halitosisman/SeniorDesign/Pcb/Main/Main.png

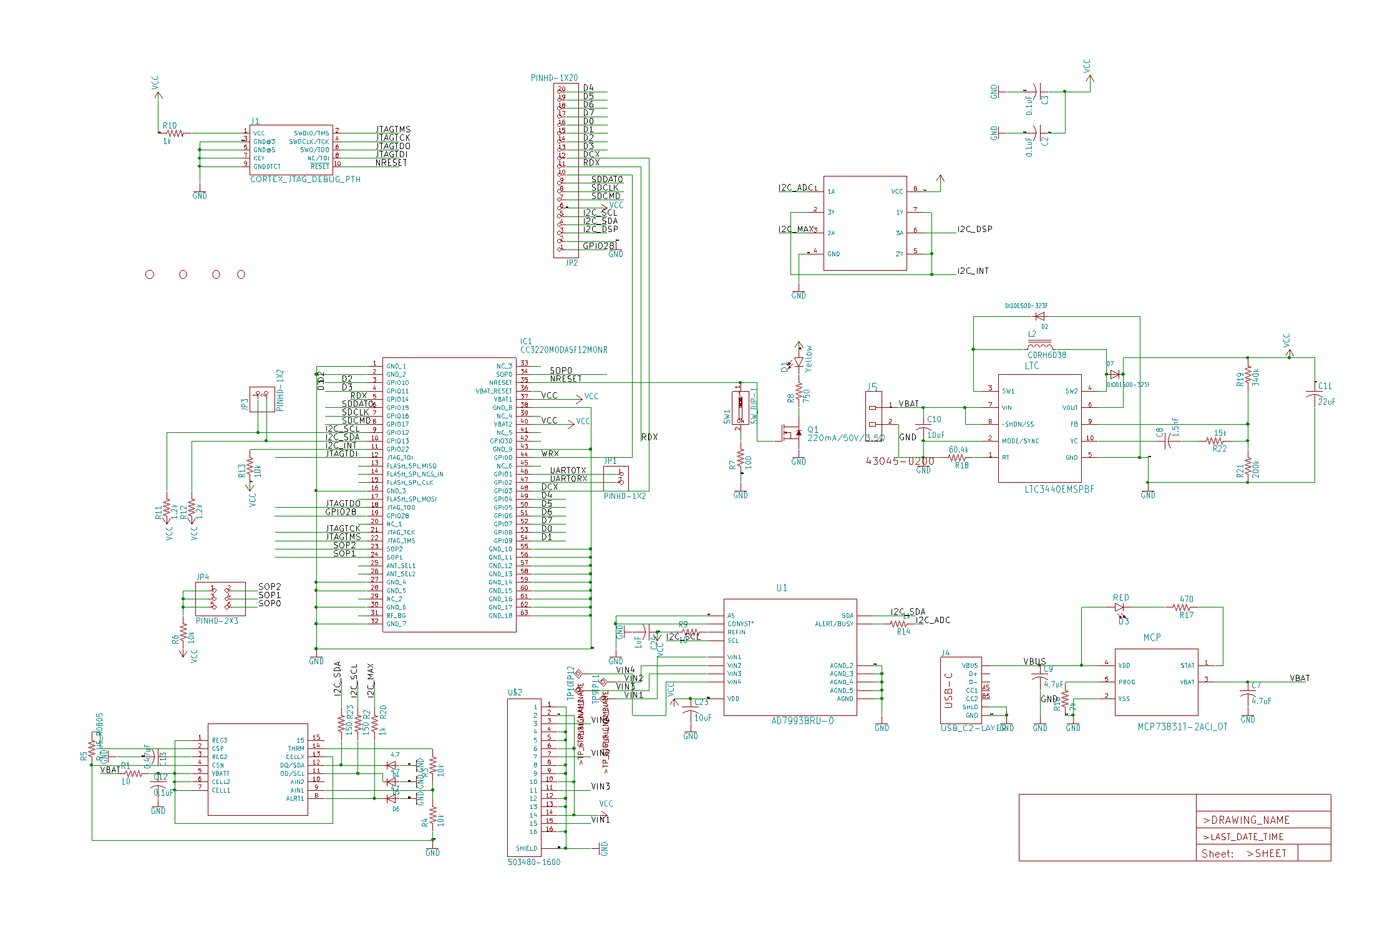
Pcb/Main/Main.png
