halitosisman/SeniorDesign/(list of files, cad)

Other CAD files:
Mechanical/3d/MockupV1.blend
