halitosisman/SeniorDesign/Pcb/Display/Display.brd

## EAGLE design Pcb/Display/Display.brd (2020-04-03)

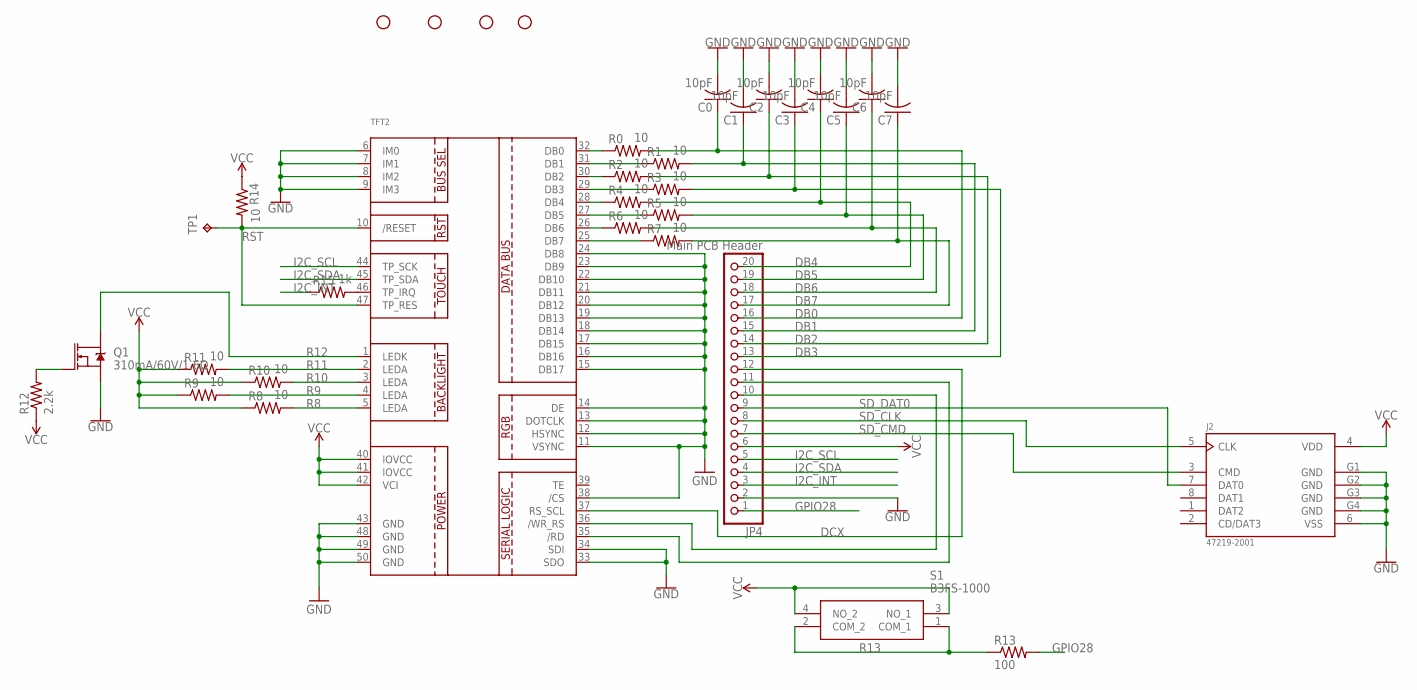
[picture p6: schematic Display.sch]

Parts:
C0, C1, C2, C3, C4, C5, C6, C7: 10pF; C0805
H1, H2, H3, H4: STAND-OFF
J2: 47219-2001; MOLEX_47219-2001
JP4: Main PCB Header; 1X20
Q1: 310mA/60V/1.6Ω; SOT323
R0, R1, R2, R3, R4, R5, R6, R7, R8, R9, R10, R11, R14: 10; R0805
R12: 2.2k; M0805
R13: 100; R0805
R15: 1k; R0805
S1: B3FS-1000; B3FS1000
TFT2: DISP_LCD_CTP28_DATASHEET; TFT_CTP28
TP1: TPTP09R; TP09R

Connections:
DB0: C0.1, JP4.16, R0.2
DB1: C1.1, JP4.15, R1.2
DB2: C2.1, JP4.14, R2.2
DB3: C3.1, JP4.13, R3.2
DB4: C4.1, JP4.20, R4.2
DB5: C5.1, JP4.19, R5.2
DB6: C6.1, JP4.18, R6.2
DB7: C7.1, JP4.17, R7.2
DCX: JP4.12, TFT2.37 (RS_SCL)
GND: C0.2, C1.2, C2.2, C3.2, C4.2, C5.2, C6.2, C7.2, J2.6 (VSS), J2.G1 (GND), J2.G2 (GND), J2.G3 (GND), J2.G4 (GND), JP4.2, Q1.2 (S), TFT2.6 (IM0), TFT2.7 (IM1), TFT2.8 (IM2), TFT2.9 (IM3), TFT2.11 (VSYNC), TFT2.12 (HSYNC), TFT2.13 (DOTCLK), TFT2.14 (DE), TFT2.15 (DB17), TFT2.16 (DB16), TFT2.17 (DB15), TFT2.18 (DB14), TFT2.19 (DB13), TFT2.20 (DB12), TFT2.21 (DB11), TFT2.22 (DB10), TFT2.23 (DB9), TFT2.24 (DB8), TFT2.33 (SDO), TFT2.34 (SDI), TFT2.38 (/CS), TFT2.43 (GND), TFT2.48 (GND), TFT2.49 (GND), TFT2.50 (GND)
GPIO28: JP4.1, R13.2
I2C_INT: JP4.3, R15.1
I2C_SCL: JP4.5, TFT2.44 (TP_SCK)
I2C_SDA: JP4.4, TFT2.45 (TP_SDA)
unnamed: R0.1, TFT2.32 (DB0)
unnamed: R1.1, TFT2.31 (DB1)
unnamed: R2.1, TFT2.30 (DB2)
unnamed: R15.2, TFT2.46 (TP_IRQ)
unnamed: R3.1, TFT2.29 (DB3)
unnamed: R4.1, TFT2.28 (DB4)
unnamed: R5.1, TFT2.27 (DB5)
unnamed: R7.1, TFT2.25 (DB7)
unnamed: R6.1, TFT2.26 (DB6)
unnamed: Q1.1 (G), R12.2
R8: R8.2, TFT2.5 (LEDA)
R9: R9.2, TFT2.4 (LEDA)
R10: R10.2, TFT2.3 (LEDA)
R11: R11.2, TFT2.2 (LEDA)
R12: Q1.3 (D), TFT2.1 (LEDK)
R13: R13.1, S1.1 (COM_1), S1.2 (COM_2)
RDX: JP4.11, TFT2.35 (/RD)
RST: R14.2, TFT2.10 (/RESET), TFT2.47 (TP_RES), TP1.TP
SD_CLK: J2.5 (CLK), JP4.8
SD_CMD: J2.3 (CMD), JP4.7
SD_DAT0: J2.7 (DAT0), JP4.9
VCC: J2.4 (VDD), JP4.6, R8.1, R9.1, R10.1, R11.1, R12.1, R14.1, S1.3 (NO_1), S1.4 (NO_2), TFT2.40 (IOVCC), TFT2.41 (IOVCC), TFT2.42 (VCI)
WRX: JP4.10, TFT2.36 (/WR_RS)

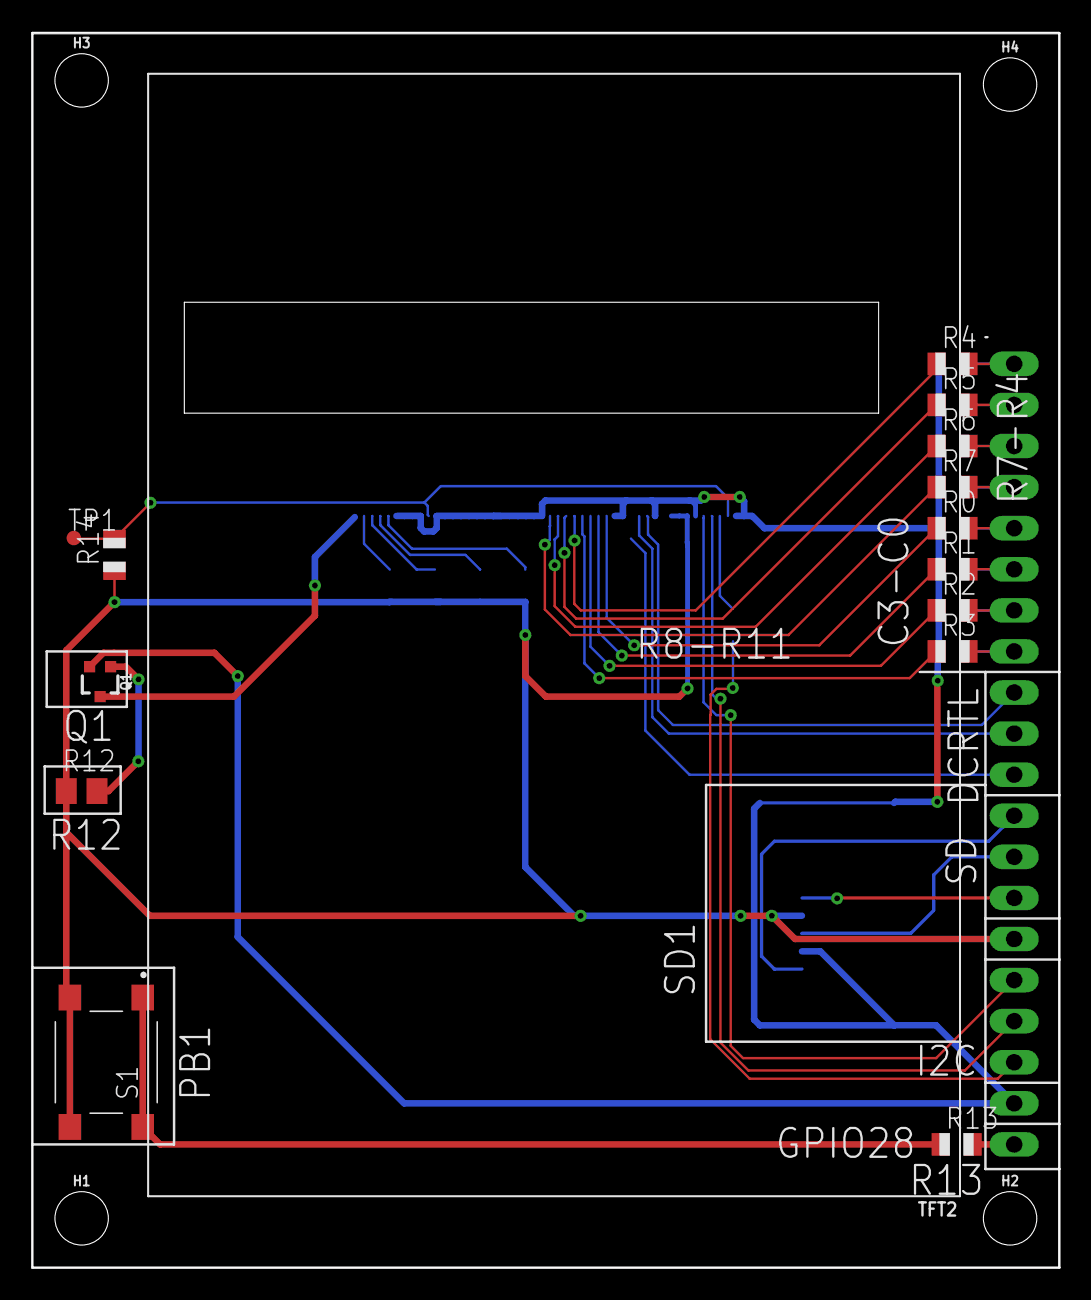
[picture p7: board Display.brd from above]

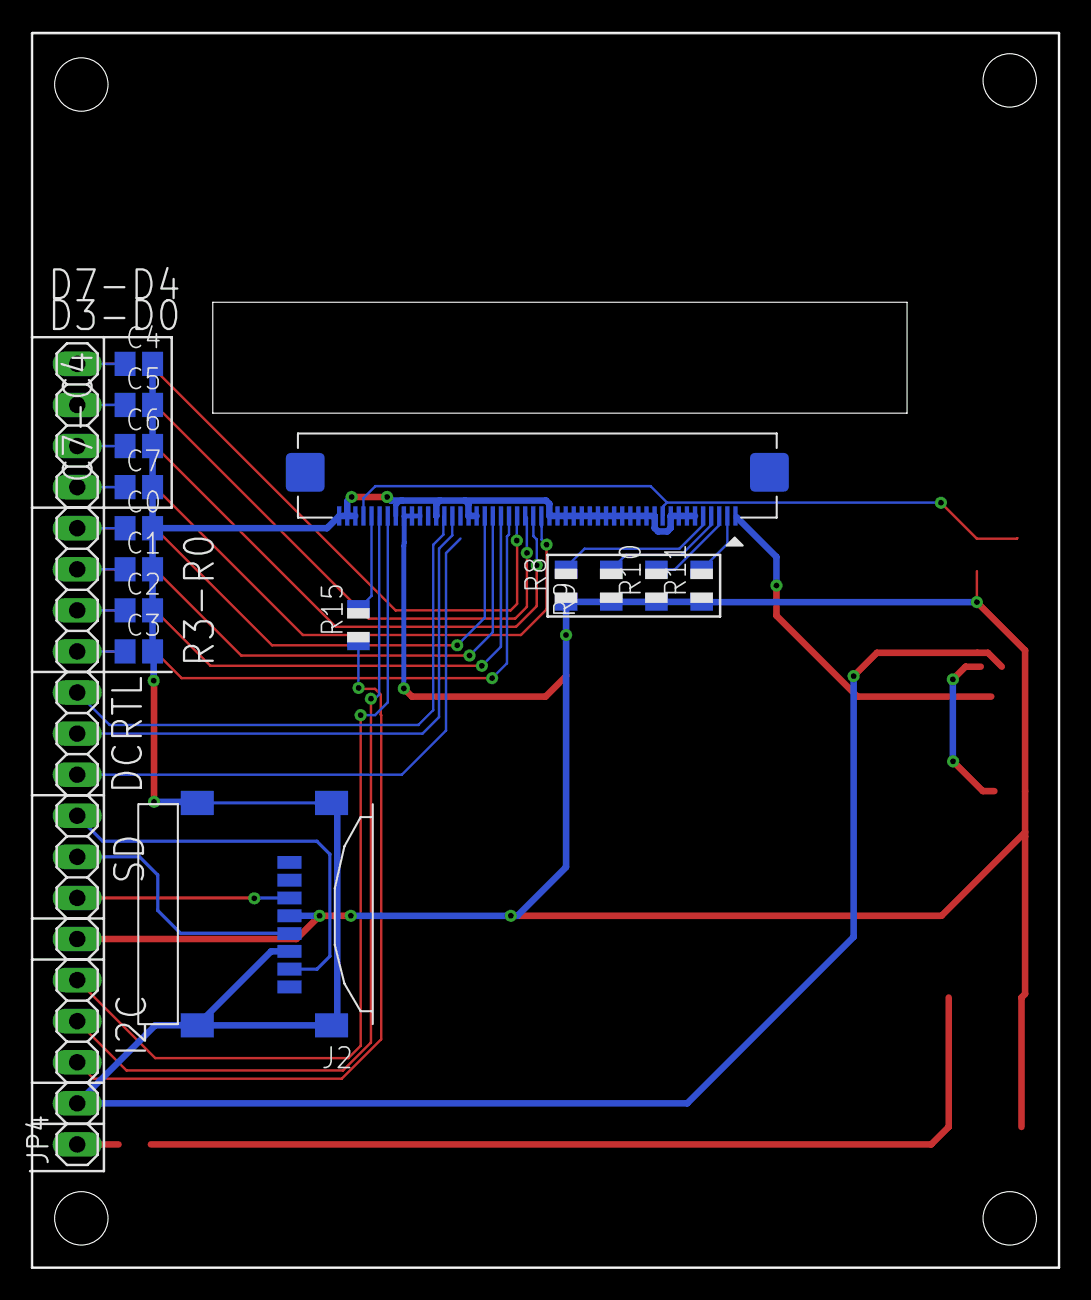
[picture p8: board Display.brd from below]

Board: 2 copper layers, 63.5 x 76.4 mm, 34 parts (15 on the bottom side), 37 nets.
