halitosisman/SeniorDesign/Pcb/Main/Main_v3.brd

## EAGLE design Pcb/Main/Main_v3.brd (2020-04-03)

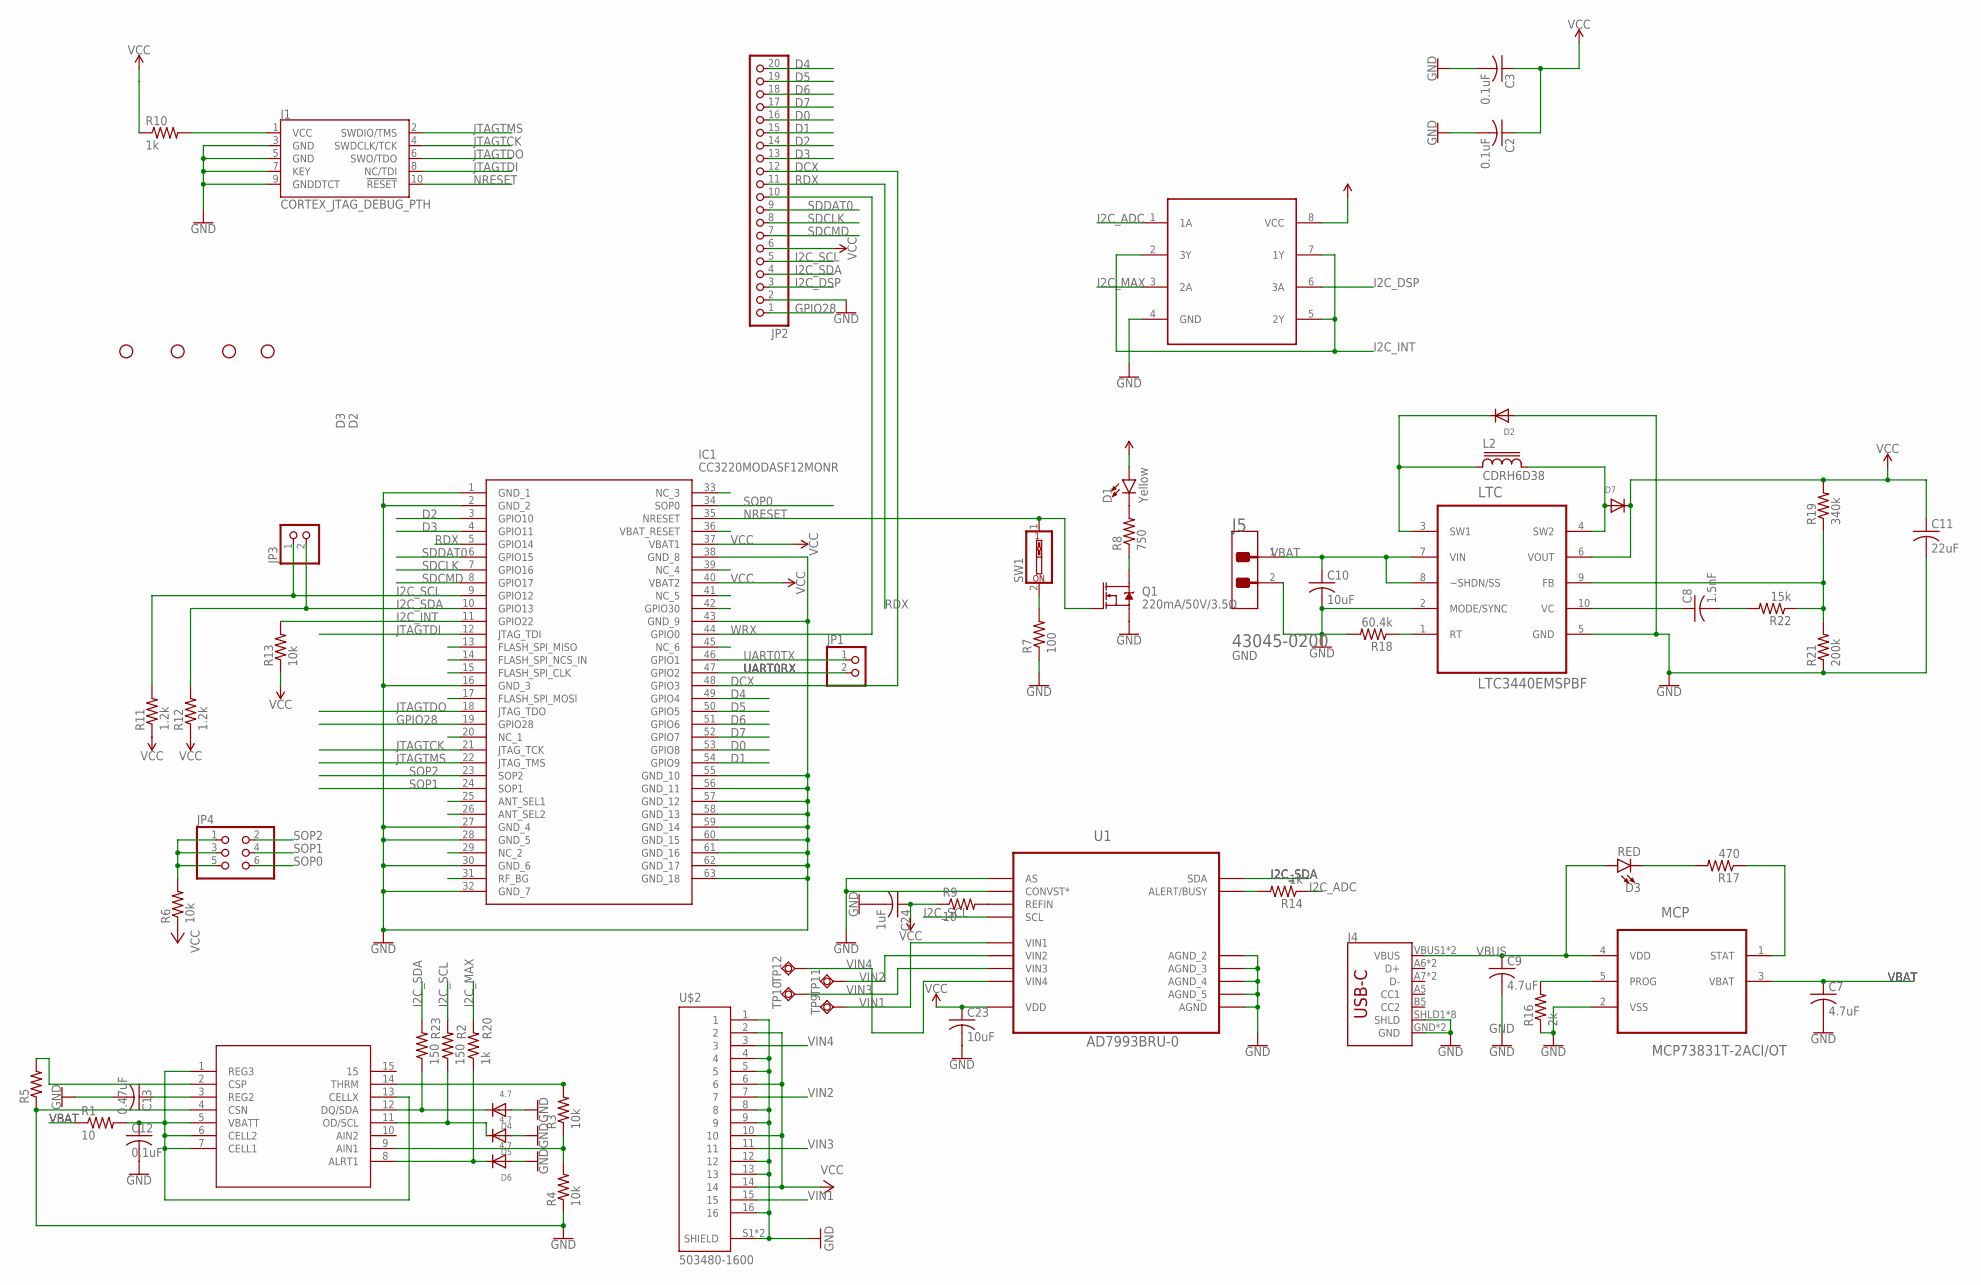
[picture p9: schematic Main_v3.sch]

Parts:
74LVC: SOP65P400X110-8N
C2, C3, C12: 0.1uF; C0805
C7, C9: 4.7uF; C0805
C8: 1.5nF; C0805
C10, C23: 10uF; C0805
C11: 22uF; C1210
C13: 0.47uF; C0805
C24: 1uF; C0805
D1: Yellow; LED-0603
D2, D7: DIODESOD-323F; SOD-323F
D3: RED; LED-0603
D4, D5, D6: 4.7; SOD-323F
H1, H2, H3, H4: STAND-OFF
IC1: CC3220MODASF12MONR; CC3220MODASM2MONR
J1: CORTEX_JTAG_DEBUG_PTH; 2X5-PTH-1.27MM
J4: USB_C2-LAYER; USB-C-16P
J5: MOLEX_43045-0200MOLEX_43045-0200_0_0; MOLEX_43045-0200_0
JP1, JP3: PINHD-1X2; 1X02
JP2: PINHD-1X20; 1X20
JP4: PINHD-2X3; 2X03
L2: CDRH6D38; CDRH6D
LTC: LTC3440EMSPBF; SOP50P490X110-10N
MAX: MAX17201G+T; 21-0137I_T1433-1
MCP: MCP73831T-2ACI/OT; SOT95P280X145-5N
Q1: 220mA/50V/3.5Ω; SOT23-3
R1, R9: 10; R0805
R2, R23: 150; R0805
R3, R4, R6, R13: 10k; R0805
R5: R-US_R0805; R0805
R7: 100; R0805
R8: 750; R0805
R10, R14, R20: 1k; R0805
R11, R12: 1.2k; R0805
R16: 2k; R0805
R17: 470; R0805
R18: 60.4k; R0805
R19: 340k; R0805
R21: 200k; R0805
R22: 15k; R0805
SW1: SW_DIP-1; EDG-01
TP9, TP10, TP11, TP12: TPSQTP12R; TP12R
U1: AD7993BRU-0; SOP65P640X120-16N
U$2: 503480-1600; MOLEX_503480-1600

Connections:
D0: IC1.53 (GPIO8), JP2.16
D1: IC1.54 (GPIO9), JP2.15
D2: IC1.3 (GPIO10), JP2.14
D3: IC1.4 (GPIO11), JP2.13
D4: IC1.49 (GPIO4), JP2.20
D5: IC1.50 (GPIO5), JP2.19
D6: IC1.51 (GPIO6), JP2.18
D7: IC1.52 (GPIO7), JP2.17
DCX: IC1.48 (GPIO3), JP2.12
GND: 74LVC.4 (GND), C2.2, C3.2, C7.2, C9.2, C10.2, C11.2, C12.2, C13.2, C23.2, C24.2, D2.A, D4.A, D5.A, D6.A, IC1.1 (GND_1), IC1.2 (GND_2), IC1.16 (GND_3), IC1.27 (GND_4), IC1.28 (GND_5), IC1.30 (GND_6), IC1.32 (GND_7), IC1.38 (GND_8), IC1.43 (GND_9), IC1.55 (GND_10), IC1.56 (GND_11), IC1.57 (GND_12), IC1.58 (GND_13), IC1.59 (GND_14), IC1.60 (GND_15), IC1.61 (GND_16), IC1.62 (GND_17), IC1.63 (GND_18), J1.3 (GND), J1.5 (GND), J1.7 (KEY), J1.9 (GNDDTCT), J4.GND, J4.GND2 (GND), J4.SHLD1 (SHLD), J4.SHLD2 (SHLD), J4.SHLD3 (SHLD), J4.SHLD4 (SHLD), J4.SHLD5 (SHLD), J4.SHLD6 (SHLD), J4.SHLD7 (SHLD), J4.SHLD8 (SHLD), J5.2, JP2.2, LTC.2 (MODE/SYNC), LTC.5 (GND), MAX.4 (CSN), MCP.2 (VSS), Q1.2 (S), R4.1, R5.1, R7.1, R16.1, R18.2, R21.1, U1.1 (AGND_2), U1.2 (AGND_3), U1.3 (AGND_4), U1.4 (AGND_5), U1.11 (AS), U1.12 (CONVST*), U1.16 (AGND), U$2.1, U$2.4, U$2.5, U$2.8, U$2.9, U$2.12, U$2.13, U$2.16, U$2.S1 (SHIELD), U$2.S2 (SHIELD)
GPIO28: IC1.19 (GPIO28), JP2.1
I2C_ADC: 74LVC.1 (1A), R14.1
I2C_DSP: 74LVC.6 (3A), JP2.3
I2C_INT: 74LVC.2 (3Y), 74LVC.5 (2Y), 74LVC.7 (1Y), IC1.11 (GPIO22), R13.2
I2C_MAX: 74LVC.3 (2A), R20.2
I2C_SCL: IC1.9 (GPIO12), JP2.5, JP3.1, R2.2, R11.2, U1.15 (SCL)
I2C_SDA: IC1.10 (GPIO13), JP2.4, JP3.2, R12.2, R23.2, U1.14 (SDA)
JTAGTCK: IC1.21 (JTAG_TCK), J1.4 (SWDCLK/TCK)
JTAGTDI: IC1.12 (JTAG_TDI), J1.8 (NC/TDI)
JTAGTDO: IC1.18 (JTAG_TDO), J1.6 (SWO/TDO)
JTAGTMS: IC1.22 (JTAG_TMS), J1.2 (SWDIO/TMS)
JTAG_R: J1.1 (VCC), R10.2
LTC_CRS: C8.2, R22.2
LTC_FB: LTC.9 (FB), R19.1, R21.2, R22.1
LTC_IND1: D2.C, L2.1, LTC.3 (SW1)
LTC_IND2: D7.A, L2.2, LTC.4 (SW2)
LTC_RT: LTC.1 (RT), R18.1
LTC_VC: C8.1, LTC.10 (VC)
MAX_AIN1: MAX.9 (AIN1), R3.1, R4.2
MAX_CSP: MAX.2 (CSP), R5.2
MAX_INT: D6.C, MAX.8 (ALRT1), R20.1
MAX_REG2: C13.1, MAX.3 (REG2)
MAX_SCL: D5.C, MAX.11 (OD/SCL), R2.1
MAX_SDA: D4.C, MAX.12 (DQ/SDA), R23.1
MAX_THRM: MAX.14 (THRM), R3.2
MAX_VBAT: C12.1, MAX.1 (REG3), MAX.5 (VBATT), MAX.6 (CELL2), MAX.7 (CELL1), MAX.13 (CELLX), R1.2
MPC_LED: D3.C, R17.2
MPC_RPROG: MCP.5 (PROG), R16.2
MPC_STAT: MCP.1 (STAT), R17.1
unnamed: JP4.1, JP4.3, JP4.5, R6.2
unnamed: R9.2, U1.6 (REFIN)
unnamed: R14.2, U1.13 (ALERT/BUSY)
NRESET: IC1.35 (NRESET), J1.10 (!RESET), Q1.1 (G), SW1.1
RDX: IC1.5 (GPIO14), JP2.11
RESET_DIODE: D1.C, R8.2
RESET_MOS: Q1.3 (D), R8.1
RESET_SW1: R7.2, SW1.2
SDCLK: IC1.7 (GPIO16), JP2.8
SDCMD: IC1.8 (GPIO17), JP2.7
SDDAT0: IC1.6 (GPIO15), JP2.9
SOP0: IC1.34 (SOP0), JP4.6
SOP1: IC1.24 (SOP1), JP4.4
SOP2: IC1.23 (SOP2), JP4.2
UART0RX: IC1.47 (GPIO2), JP1.2
UART0TX: IC1.46 (GPIO1), JP1.1
VBAT: C7.1, C10.1, J5.1, LTC.7 (VIN), LTC.8 (~SHDN/SS), MCP.3 (VBAT), R1.1
VBUS: C9.1, D3.A, J4.VBUS1 (VBUS), J4.VBUS2 (VBUS), MCP.4 (VDD)
VCC: 74LVC.8 (VCC), C2.1, C3.1, C11.1, C23.1, C24.1, D1.A, D7.C, IC1.37 (VBAT1), IC1.40 (VBAT2), JP2.6, LTC.6 (VOUT), R6.1, R9.1, R10.1, R11.1, R12.1, R13.1, R19.2, U1.5 (VDD), U$2.2, U$2.6, U$2.10, U$2.14
VIN1: TP9.TP, U1.7 (VIN1), U$2.15
VIN2: TP11.TP, U1.10 (VIN2), U$2.7
VIN3: TP10.TP, U1.8 (VIN3), U$2.11
VIN4: TP12.TP, U1.9 (VIN4), U$2.3
WRX: IC1.44 (GPIO0), JP2.10

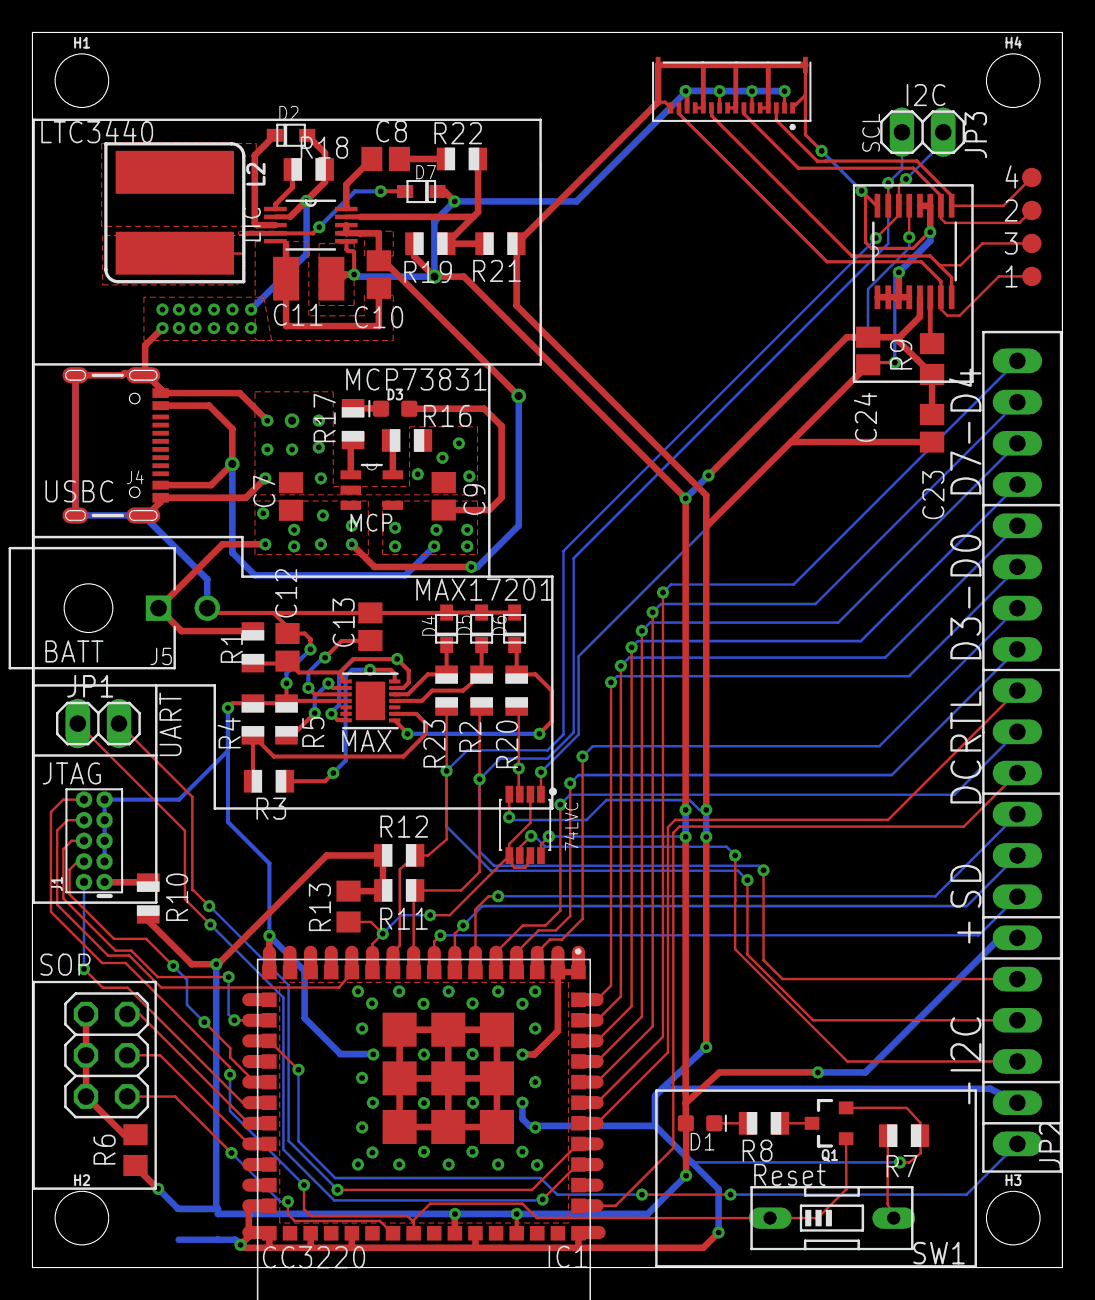
[picture p10: board Main_v3.brd from above]

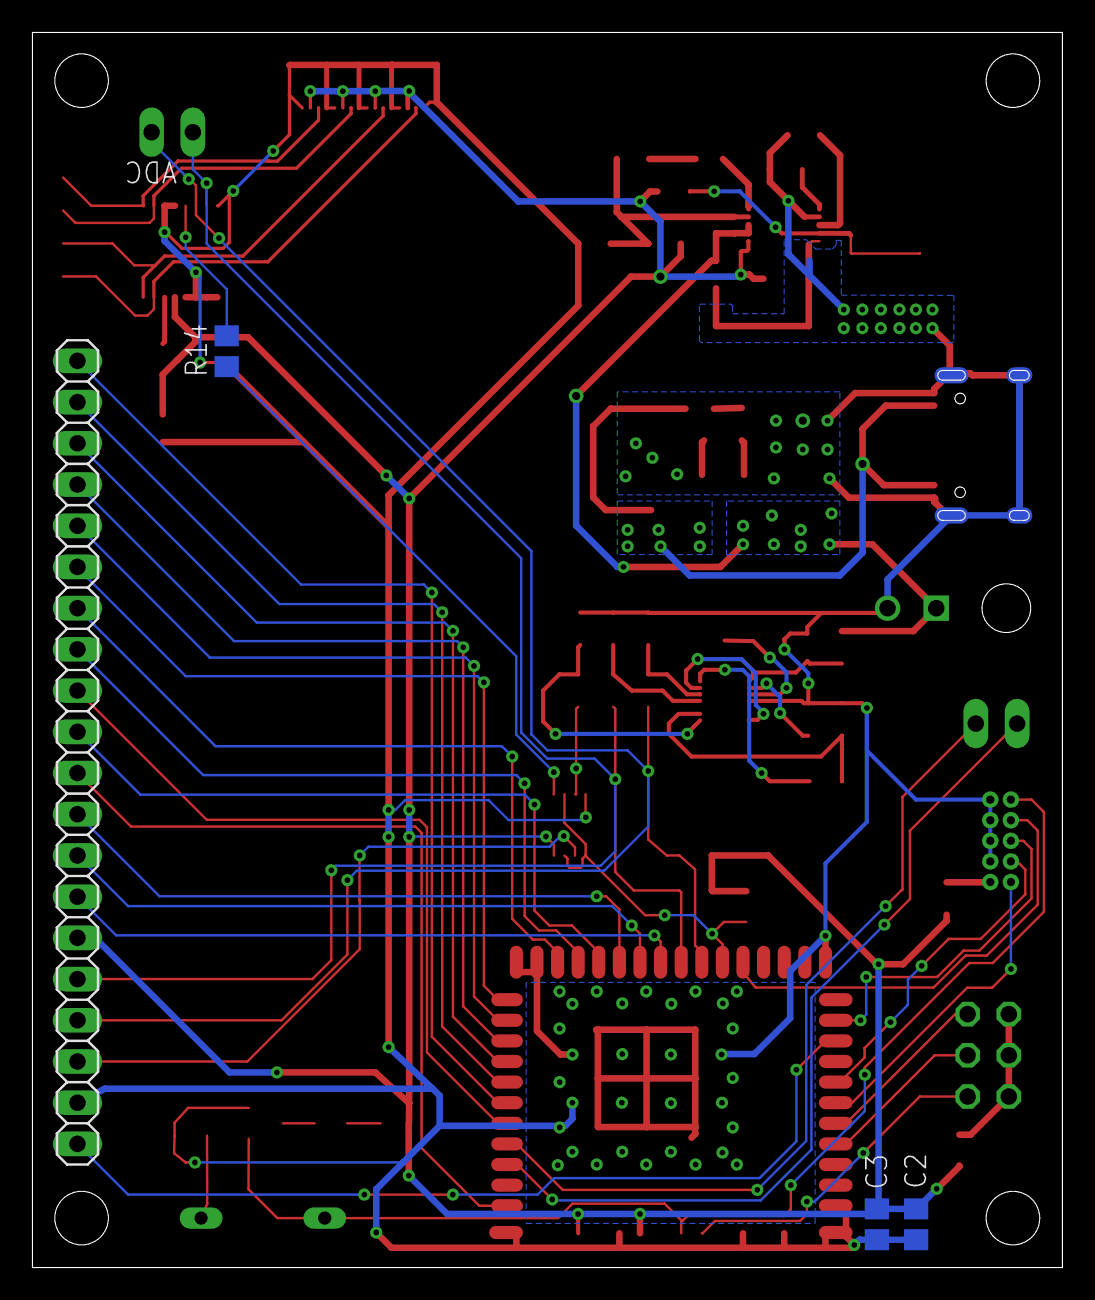
[picture p11: board Main_v3.brd from below]

Board: 2 copper layers, 63.5 x 76.1 mm, 65 parts (4 on the bottom side), 63 nets.
