halitosisman/SeniorDesign/Pcb/HallE/HallE.brd

## EAGLE design Pcb/HallE/HallE.brd (2020-03-09)

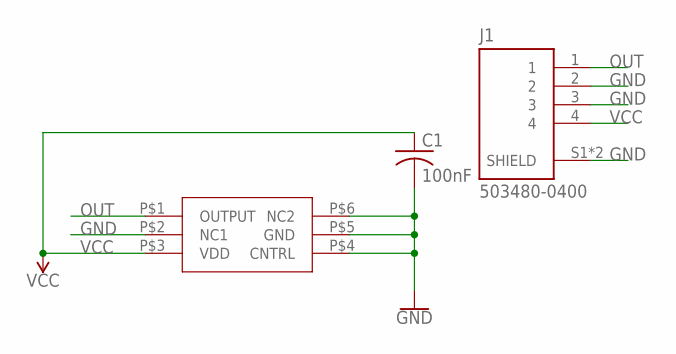
[picture p12: schematic HallE.sch]

Parts:
C1: 100nF; C0805
J1: 503480-0400; MOLEX_503480-0400
U$1: AH8503; UDFN-6

Connections:
GND: C1.2, J1.2, J1.3, J1.S1 (SHIELD), J1.S2 (SHIELD), U$1.P$2 (NC1), U$1.P$4 (CNTRL), U$1.P$5 (GND), U$1.P$6 (NC2)
OUT: J1.1, U$1.P$1 (OUTPUT)
VCC: C1.1, J1.4, U$1.P$3 (VDD)

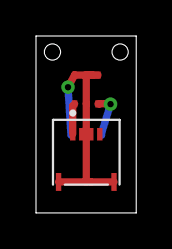
[picture p13: board HallE.brd from above]

Board: 2 copper layers, 5.6 x 9.8 mm, 3 parts (1 on the bottom side), 3 nets.
