halitosisman/SeniorDesign/GauntletMCU/CCS_Project/Finity_MCU_Core/main_freertos.cpp

/*
 * Copyright (c) 2016-2019, Texas Instruments Incorporated
 * All rights reserved.
 *
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
 * *  Redistributions of source code must retain the above copyright
 *    notice, this list of conditions and the following disclaimer.
 *
 * *  Redistributions in binary form must reproduce the above copyright
 *    notice, this list of conditions and the following disclaimer in the
 *    documentation and/or other materials provided with the distribution.
 *
 * *  Neither the name of Texas Instruments Incorporated nor the names of
 *    its contributors may be used to endorse or promote products derived
 *    from this software without specific prior written permission.
 *
 * THIS SOFTWARE IS PROVIDED BY THE COPYRIGHT HOLDERS AND CONTRIBUTORS "AS IS"
 * AND ANY EXPRESS OR IMPLIED WARRANTIES, INCLUDING, BUT NOT LIMITED TO,
 * THE IMPLIED WARRANTIES OF MERCHANTABILITY AND FITNESS FOR A PARTICULAR
 * PURPOSE ARE DISCLAIMED. IN NO EVENT SHALL THE COPYRIGHT OWNER OR
 * CONTRIBUTORS BE LIABLE FOR ANY DIRECT, INDIRECT, INCIDENTAL, SPECIAL,
 * EXEMPLARY, OR CONSEQUENTIAL DAMAGES (INCLUDING, BUT NOT LIMITED TO,
 * PROCUREMENT OF SUBSTITUTE GOODS OR SERVICES; LOSS OF USE, DATA, OR PROFITS;
 * OR BUSINESS INTERRUPTION) HOWEVER CAUSED AND ON ANY THEORY OF LIABILITY,
 * WHETHER IN CONTRACT, STRICT LIABILITY, OR TORT (INCLUDING NEGLIGENCE OR
 * OTHERWISE) ARISING IN ANY WAY OUT OF THE USE OF THIS SOFTWARE,
 * EVEN IF ADVISED OF THE POSSIBILITY OF SUCH DAMAGE.
 */

/*
 *  ======== main_freertos.c ========
 */


#include "string.h"

/* POSIX Header files */
#include <pthread.h>

/* RTOS header files */
#include <tasks/gui_task/gui_task.h>
#include <tasks/i2c_task/i2c_task.h>
#include <tasks/net_task/net_task.h>
#include "FreeRTOS.h"
#include "task.h"

#include "tasks/FGTask.h"

#include "configs/Board.h"
#include "configs/thread_config.h"

pthread_t thread;
pthread_t i2c_thread;
pthread_t gui_thread;
FGthread_arg_t thread_args;
/*
 *  ======== main ========
 */
int main(void)
{
    pthread_attr_t pAttrs;
    struct sched_param priParam;
    int retc;
    int detachState;

    /* Call driver init functions */
    Board_init();

    /* Set priority and stack size attributes */
    pthread_attr_init(&pAttrs);
    priParam.sched_priority = I2C_THREAD_PRIORITY; // 1

    detachState = PTHREAD_CREATE_DETACHED;
    retc = pthread_attr_setdetachstate(&pAttrs, detachState);
    if(retc != 0)
    {
        while(1)
        {
            ;
        }
    }

    pthread_attr_setschedparam(&pAttrs, &priParam);

    retc |= pthread_attr_setstacksize(&pAttrs, I2C_THREAD_STACK_SIZE * 4);
    if(retc != 0)
    {
        while(1)
        {
            ;
        }
    }

    retc = pthread_create(&i2c_thread, &pAttrs, (void * (*) (void *))i2c_task, &thread_args);
    if(retc != 0)
    {
        while(1)
        {
            ;
        }
    }



    pthread_attr_init(&pAttrs);
    priParam.sched_priority = NET_TASK_SPAWNER_PRIORITY; // 1

    detachState = PTHREAD_CREATE_DETACHED;
    retc = pthread_attr_setdetachstate(&pAttrs, detachState);
    if(retc != 0)
    {
        while(1)
        {
            ;
        }
    }

    pthread_attr_setschedparam(&pAttrs, &priParam);

    retc |= pthread_attr_setstacksize(&pAttrs, 4096);
    if(retc != 0)
    {
        while(1)
        {
            ;
        }
    }

    retc = pthread_create(&thread, &pAttrs, (void * (*) (void *))net_task, &thread_args);
    if(retc != 0)
    {
        while(1)
        {
            ;
        }
    }
    /* Set priority and stack size attributes */
    pthread_attr_init(&pAttrs);
    priParam.sched_priority = GUI_THREAD_PRIORITY;

    detachState = PTHREAD_CREATE_DETACHED;
    retc = pthread_attr_setdetachstate(&pAttrs, detachState);
    if(retc != 0)
    {
        /* pthread_attr_setdetachstate() failed */
        while(1)
        {
            ;
        }
    }

    pthread_attr_setschedparam(&pAttrs, &priParam);

    retc |= pthread_attr_setstacksize(&pAttrs, GUI_THREAD_STACK_SIZE * 4);
    if(retc != 0)
    {
        /* pthread_attr_setstacksize() failed */
        while(1)
        {
            ;
        }
    }

    retc = pthread_create(&gui_thread, &pAttrs, (void * (*) (void *))gui_task, &thread_args);
    if(retc != 0)
    {
        /* pthread_create() failed */
        while(1)
        {
            ;
        }
    }

    /* Start the FreeRTOS scheduler */
    vTaskStartScheduler();


    return (0);
}


#ifdef __cplusplus
extern "C" {
#endif

//*****************************************************************************
//
//! \brief Application defined malloc failed hook
//!
//! \param  none
//!
//! \return none
//!
//*****************************************************************************
void vApplicationMallocFailedHook()
{
    /* Handle Memory Allocation Errors */
    while(1)
    {
    }
}

//*****************************************************************************
//
//! \brief Application defined stack overflow hook
//!
//! \param  none
//!
//! \return none
//!
//*****************************************************************************
void vApplicationStackOverflowHook(TaskHandle_t pxTask, char *pcTaskName)
{
    //Handle FreeRTOS Stack Overflow
    while(1)
    {
    }
}

#ifdef __cplusplus
}
#endif
