halitosisman/SeniorDesign/GauntletMCU/CCS_Project/Finity_MCU_Core/configs/CC3220SF.c

/*
 * Copyright (c) 2016-2019, Texas Instruments Incorporated
 * All rights reserved.
 *
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
 * *  Redistributions of source code must retain the above copyright
 *    notice, this list of conditions and the following disclaimer.
 *
 * *  Redistributions in binary form must reproduce the above copyright
 *    notice, this list of conditions and the following disclaimer in the
 *    documentation and/or other materials provided with the distribution.
 *
 * *  Neither the name of Texas Instruments Incorporated nor the names of
 *    its contributors may be used to endorse or promote products derived
 *    from this software without specific prior written permission.
 *
 * THIS SOFTWARE IS PROVIDED BY THE COPYRIGHT HOLDERS AND CONTRIBUTORS "AS IS"
 * AND ANY EXPRESS OR IMPLIED WARRANTIES, INCLUDING, BUT NOT LIMITED TO,
 * THE IMPLIED WARRANTIES OF MERCHANTABILITY AND FITNESS FOR A PARTICULAR
 * PURPOSE ARE DISCLAIMED. IN NO EVENT SHALL THE COPYRIGHT OWNER OR
 * CONTRIBUTORS BE LIABLE FOR ANY DIRECT, INDIRECT, INCIDENTAL, SPECIAL,
 * EXEMPLARY, OR CONSEQUENTIAL DAMAGES (INCLUDING, BUT NOT LIMITED TO,
 * PROCUREMENT OF SUBSTITUTE GOODS OR SERVICES; LOSS OF USE, DATA, OR PROFITS;
 * OR BUSINESS INTERRUPTION) HOWEVER CAUSED AND ON ANY THEORY OF LIABILITY,
 * WHETHER IN CONTRACT, STRICT LIABILITY, OR TORT (INCLUDING NEGLIGENCE OR
 * OTHERWISE) ARISING IN ANY WAY OUT OF THE USE OF THIS SOFTWARE,
 * EVEN IF ADVISED OF THE POSSIBILITY OF SUCH DAMAGE.
 */

/*
 * This file was mostly derived from example config files generated by TI's
 * sysconfig utility. Many of the structures here were modified to meet
 * the demands of the Finity Gauntlet.
 */

/*
 *  ======== CC3220SF.c ========
 *  This file is responsible for setting up the board specific items for the
 *  CC3220SF board.
 */

#include <configs/CC3220SF.h>
#include <stdbool.h>
#include <stddef.h>
#include <stdint.h>

#include <ti/devices/cc32xx/inc/hw_ints.h>
#include <ti/devices/cc32xx/inc/hw_memmap.h>
#include <ti/devices/cc32xx/inc/hw_types.h>

#include <ti/drivers/SPI.h>
#include <ti/drivers/GPIO.h>

#include <ti/devices/cc32xx/driverlib/rom.h>
#include <ti/devices/cc32xx/driverlib/rom_map.h>
#include <ti/devices/cc32xx/driverlib/adc.h>
#include <ti/devices/cc32xx/driverlib/gpio.h>
#include <ti/devices/cc32xx/driverlib/pin.h>
#include <ti/devices/cc32xx/driverlib/prcm.h>
#include <ti/devices/cc32xx/driverlib/spi.h>
#include <ti/devices/cc32xx/driverlib/sdhost.h>
#include <ti/devices/cc32xx/driverlib/timer.h>
#include <ti/devices/cc32xx/driverlib/uart.h>
#include <ti/devices/cc32xx/driverlib/udma.h>
#include <ti/devices/cc32xx/driverlib/wdt.h>

#include <ti/drivers/Power.h>
#include <ti/drivers/power/PowerCC32XX.h>


/*
 *  This define determines whether to use the UARTCC32XXDMA driver
 *  or the UARTCC32XX (no DMA) driver.  Set to 1 to use the UARTCC32XXDMA
 *  driver.
 */
#ifndef TI_DRIVERS_UART_DMA
#define TI_DRIVERS_UART_DMA 0
#endif

/*
 *  =============================== DMA ===============================
 */
#include <ti/drivers/dma/UDMACC32XX.h>

static tDMAControlTable dmaControlTable[64] __attribute__ ((aligned (1024)));

/*
 *  ======== dmaErrorFxn ========
 *  This is the handler for the uDMA error interrupt.
 */
static void dmaErrorFxn(uintptr_t arg)
{
    int status = MAP_uDMAErrorStatusGet();
    MAP_uDMAErrorStatusClear();

    /* Suppress unused variable warning */
    (void)status;

    while (1);
}

UDMACC32XX_Object udmaCC3220SObject;

const UDMACC32XX_HWAttrs udmaCC3220SHWAttrs = {
    .controlBaseAddr = (void *)dmaControlTable,
    .dmaErrorFxn = (UDMACC32XX_ErrorFxn)dmaErrorFxn,
    .intNum = INT_UDMAERR,
    .intPriority = (~0)
};

const UDMACC32XX_Config UDMACC32XX_config = {
    .object = &udmaCC3220SObject,
    .hwAttrs = &udmaCC3220SHWAttrs
};

/*
 *  =============================== General ===============================
 */
/*
 *  ======== CC3220SF_LAUNCHXL_initGeneral ========
 */
void CC3220SF_LAUNCHXL_initGeneral(void)
{
    PRCMCC3200MCUInit();
    Power_init();
}

/*
 *  ======== Board_init ========
 */
void Board_init(void)
{
    CC3220SF_LAUNCHXL_initGeneral();
    GPIO_init();
    SPI_init();
    I2C_init();
    /*Configure the UART                                                     */
    uart_debug = InitTerm();
    /*remove uart receive from LPDS dependency                               */
    UART_control(uart_debug, UART_CMD_RXDISABLE, NULL);
}


/*
 *  =============================== I2C ===============================
 */
#include <ti/drivers/I2C.h>
#include <ti/drivers/i2c/I2CCC32XX.h>

I2CCC32XX_Object i2cCC3220SObjects[1];

const I2CCC32XX_HWAttrsV1 i2cCC3220SHWAttrs[1] = {
    {
        .baseAddr = I2CA0_BASE,
        .intNum = INT_I2CA0,
        .intPriority = (~0),
        .clkPin = I2CCC32XX_PIN_03_I2C_SCL,
        .dataPin = I2CCC32XX_PIN_04_I2C_SDA
    }
};

const I2C_Config I2C_config[1] = {
    {
        .fxnTablePtr = &I2CCC32XX_fxnTable,
        .object = &i2cCC3220SObjects[0],
        .hwAttrs = &i2cCC3220SHWAttrs[0]
    }
};

const uint_least8_t I2C_count = 1;


/*
 *  =============================== Power ===============================
 */
/*
 * This table defines the parking state to be set for each parkable pin
 * during LPDS. (Device pins must be parked during LPDS to achieve maximum
 * power savings.)  If the pin should be left unparked, specify the state
 * PowerCC32XX_DONT_PARK.  For example, for a UART TX pin, the device
 * will automatically park the pin in a high state during transition to LPDS,
 * so the Power Manager does not need to explictly park the pin.  So the
 * corresponding entries in this table should indicate PowerCC32XX_DONT_PARK.
 */
PowerCC32XX_ParkInfo parkInfo[] = {
/*          PIN                    PARK STATE              PIN ALIAS (FUNCTION)
     -----------------  ------------------------------     -------------------- */
    {PowerCC32XX_PIN01, PowerCC32XX_WEAK_PULL_DOWN_STD}, /* GPIO10              */
    {PowerCC32XX_PIN02, PowerCC32XX_WEAK_PULL_DOWN_STD}, /* GPIO11              */
    {PowerCC32XX_PIN03, PowerCC32XX_WEAK_PULL_DOWN_STD}, /* GPIO12              */
    {PowerCC32XX_PIN04, PowerCC32XX_WEAK_PULL_DOWN_STD}, /* GPIO13              */
    {PowerCC32XX_PIN05, PowerCC32XX_WEAK_PULL_DOWN_STD}, /* GPIO14              */
    {PowerCC32XX_PIN06, PowerCC32XX_WEAK_PULL_DOWN_STD}, /* GPIO15              */
    {PowerCC32XX_PIN07, PowerCC32XX_WEAK_PULL_DOWN_STD}, /* GPIO16              */
    {PowerCC32XX_PIN08, PowerCC32XX_WEAK_PULL_DOWN_STD}, /* GPIO17              */
    {PowerCC32XX_PIN13, PowerCC32XX_WEAK_PULL_DOWN_STD}, /* FLASH_SPI_DIN       */
    {PowerCC32XX_PIN15, PowerCC32XX_WEAK_PULL_DOWN_STD}, /* GPIO22              */
    {PowerCC32XX_PIN16, PowerCC32XX_WEAK_PULL_DOWN_STD}, /* TDI (JTAG DEBUG)    */
    {PowerCC32XX_PIN17, PowerCC32XX_WEAK_PULL_DOWN_STD}, /* TDO (JTAG DEBUG)    */
    {PowerCC32XX_PIN19, PowerCC32XX_WEAK_PULL_DOWN_STD}, /* TCK (JTAG DEBUG)    */
    {PowerCC32XX_PIN20, PowerCC32XX_WEAK_PULL_DOWN_STD}, /* TMS (JTAG DEBUG)    */
    {PowerCC32XX_PIN18, PowerCC32XX_WEAK_PULL_DOWN_STD}, /* GPIO28              */
    {PowerCC32XX_PIN21, PowerCC32XX_WEAK_PULL_DOWN_STD}, /* SOP2                */
    {PowerCC32XX_PIN29, PowerCC32XX_WEAK_PULL_DOWN_STD}, /* ANTSEL1             */
    {PowerCC32XX_PIN30, PowerCC32XX_WEAK_PULL_DOWN_STD}, /* ANTSEL2             */
    {PowerCC32XX_PIN45, PowerCC32XX_WEAK_PULL_DOWN_STD}, /* DCDC_ANA2_SW_P      */
    {PowerCC32XX_PIN50, PowerCC32XX_WEAK_PULL_DOWN_STD}, /* GPIO0               */
    {PowerCC32XX_PIN52, PowerCC32XX_WEAK_PULL_DOWN_STD}, /* RTC_XTAL_N          */
    {PowerCC32XX_PIN53, PowerCC32XX_WEAK_PULL_DOWN_STD}, /* GPIO30              */
    {PowerCC32XX_PIN55, PowerCC32XX_WEAK_PULL_UP_STD},   /* GPIO1 (XDS_UART_RX) */
    {PowerCC32XX_PIN57, PowerCC32XX_WEAK_PULL_UP_STD},   /* GPIO2 (XDS_UART_TX) */
    {PowerCC32XX_PIN58, PowerCC32XX_WEAK_PULL_DOWN_STD}, /* GPIO3               */
    {PowerCC32XX_PIN59, PowerCC32XX_WEAK_PULL_DOWN_STD}, /* GPIO4               */
    {PowerCC32XX_PIN60, PowerCC32XX_WEAK_PULL_DOWN_STD}, /* GPIO5               */
    {PowerCC32XX_PIN61, PowerCC32XX_WEAK_PULL_DOWN_STD}, /* GPIO6               */
    {PowerCC32XX_PIN62, PowerCC32XX_WEAK_PULL_DOWN_STD}, /* GPIO7               */
    {PowerCC32XX_PIN63, PowerCC32XX_WEAK_PULL_DOWN_STD}, /* GPIO8               */
    {PowerCC32XX_PIN64, PowerCC32XX_WEAK_PULL_DOWN_STD}, /* GPIO9               */
};

/*
 *  This structure defines the configuration for the Power Manager.
 *
 *  In this configuration the Power policy is disabled by default (because
 *  enablePolicy is set to false).  The Power policy can be enabled dynamically
 *  at runtime by calling Power_enablePolicy(), or at build time, by changing
 *  enablePolicy to true in this structure.
 */
const PowerCC32XX_ConfigV1 PowerCC32XX_config = {
    .policyInitFxn = &PowerCC32XX_initPolicy,
    .policyFxn = &PowerCC32XX_sleepPolicy,
    .enterLPDSHookFxn = NULL,
    .resumeLPDSHookFxn = NULL,
    .enablePolicy = false,
    .enableGPIOWakeupLPDS = true,
    .enableGPIOWakeupShutdown = true,
    .enableNetworkWakeupLPDS = true,
    .wakeupGPIOSourceLPDS = PRCM_LPDS_GPIO13,
    .wakeupGPIOTypeLPDS = PRCM_LPDS_FALL_EDGE,
    .wakeupGPIOFxnLPDS = NULL,
    .wakeupGPIOFxnLPDSArg = 0,
    .wakeupGPIOSourceShutdown = PRCM_HIB_GPIO13,
    .wakeupGPIOTypeShutdown = PRCM_HIB_RISE_EDGE,
    .ramRetentionMaskLPDS = PRCM_SRAM_COL_1 | PRCM_SRAM_COL_2 |
        PRCM_SRAM_COL_3 | PRCM_SRAM_COL_4,
    .keepDebugActiveDuringLPDS = false,
    .ioRetentionShutdown = PRCM_IO_RET_GRP_1,
    .pinParkDefs = parkInfo,
    .numPins = sizeof(parkInfo) / sizeof(PowerCC32XX_ParkInfo)
};



/*
 *  =============================== GPIO ===============================
 */

#include <ti/drivers/GPIO.h>
#include <ti/drivers/gpio/GPIOCC32XX.h>

/*
 *  ======== gpioPinConfigs ========
 *  Array of Pin configurations
 */
GPIO_PinConfig gpioPinConfigs[] =
{
     // RDX
     GPIOCC32XX_GPIO_30 | GPIO_CFG_OUT_STD | GPIO_CFG_OUT_STR_HIGH | GPIO_CFG_OUT_LOW,
     // WRX
     GPIOCC32XX_GPIO_00 | GPIO_CFG_OUT_STD | GPIO_CFG_OUT_STR_HIGH | GPIO_CFG_OUT_LOW,
     // D/CX
     GPIOCC32XX_GPIO_03 | GPIO_CFG_OUT_STD | GPIO_CFG_OUT_STR_HIGH | GPIO_CFG_OUT_LOW,
     // D7 - D0
     GPIOCC32XX_GPIO_04 | GPIO_CFG_OUT_STD | GPIO_CFG_OUT_STR_HIGH | GPIO_CFG_OUT_LOW,
     GPIOCC32XX_GPIO_05 | GPIO_CFG_OUT_STD | GPIO_CFG_OUT_STR_HIGH | GPIO_CFG_OUT_LOW,
     GPIOCC32XX_GPIO_06 | GPIO_CFG_OUT_STD | GPIO_CFG_OUT_STR_HIGH | GPIO_CFG_OUT_LOW,
     GPIOCC32XX_GPIO_07 | GPIO_CFG_OUT_STD | GPIO_CFG_OUT_STR_HIGH | GPIO_CFG_OUT_LOW,
     GPIOCC32XX_GPIO_08 | GPIO_CFG_OUT_STD | GPIO_CFG_OUT_STR_HIGH | GPIO_CFG_OUT_LOW,
     GPIOCC32XX_GPIO_09 | GPIO_CFG_OUT_STD | GPIO_CFG_OUT_STR_HIGH | GPIO_CFG_OUT_LOW,
     GPIOCC32XX_GPIO_10 | GPIO_CFG_OUT_STD | GPIO_CFG_OUT_STR_HIGH | GPIO_CFG_OUT_LOW,
     GPIOCC32XX_GPIO_11 | GPIO_CFG_OUT_STD | GPIO_CFG_OUT_STR_HIGH | GPIO_CFG_OUT_LOW,
     // I2C_INT
     GPIOCC32XX_GPIO_28 | GPIO_DO_NOT_CONFIG
};

/*
 *  ======== gpioCallbackFunctions ========
 *  Array of callback function pointers
 *
 *  NOTE: Unused callback entries can be omitted from the callbacks array to
 *  reduce memory usage by enabling callback table optimization
 *  (GPIO.optimizeCallbackTableSize = true)
 */
GPIO_CallbackFxn gpioCallbackFunctions[GPIO_Pin_Count] =
{
     // RDX
     NULL,
     // WRX
     NULL,
     // D/CX
     NULL,
     // D7 - D0
     NULL,
     NULL,
     NULL,
     NULL,
     NULL,
     NULL,
     NULL,
     NULL,
     //I2C_INT
     NULL
};

/*
 *  ======== GPIOCC32XX_config ========
 */
const GPIOCC32XX_Config GPIOCC32XX_config = {
    .pinConfigs = (GPIO_PinConfig *)gpioPinConfigs,
    .callbacks = (GPIO_CallbackFxn *)gpioCallbackFunctions,
    .numberOfPinConfigs = sizeof(gpioPinConfigs) / sizeof(GPIO_PinConfig),
    .numberOfCallbacks = sizeof(gpioPinConfigs) / sizeof(GPIO_PinConfig),
    .intPriority = (~0)
};


/*
 *  =============================== SDFatFS ===============================
 */
#include <ti/drivers/SD.h>
#include <ti/drivers/SDFatFS.h>

/*
 * Note: The SDFatFS driver provides interface functions to enable FatFs
 * but relies on the SD driver to communicate with SD cards.  Opening a
 * SDFatFs driver instance will internally try to open a SD driver instance
 * reusing the same index number (opening SDFatFs driver at index 0 will try to
 * open SD driver at index 0).  This requires that all SDFatFs driver instances
 * have an accompanying SD driver instance defined with the same index.  It is
 * acceptable to have more SD driver instances than SDFatFs driver instances
 * but the opposite is not supported & the SDFatFs will fail to open.
 */
SDFatFS_Object sdfatfsObjects[1];

const SDFatFS_Config SDFatFS_config[1] = {
    {
        .object = &sdfatfsObjects[0]
    }
};

const uint_least8_t SDFatFS_count = 1;


/*
 *  =============================== SD ===============================
 */
#include <ti/drivers/SD.h>
#include <ti/drivers/sd/SDHostCC32XX.h>

#include <ti/devices/cc32xx/inc/hw_ints.h>
#include <ti/devices/cc32xx/inc/hw_memmap.h>

SDHostCC32XX_Object sdhostObjects[1];

const SDHostCC32XX_HWAttrsV1 sdhostHWattrs[1] = {
    /* CONFIG_SD_0 */
    {
        .clkRate = 8000000,
        .intPriority = (~0),
        .baseAddr = SDHOST_BASE,
        .rxChIdx = UDMA_CH23_SDHOST_RX,
        .txChIdx = UDMA_CH24_SDHOST_TX,
        .dataPin = SDHostCC32XX_PIN_06_SDCARD_DATA,
        .cmdPin = SDHostCC32XX_PIN_08_SDCARD_CMD,
        .clkPin  = SDHostCC32XX_PIN_07_SDCARD_CLK
    },
};

const SD_Config SD_config[1] = {
    /* CONFIG_SD_0 */
    {
        .fxnTablePtr = &sdHostCC32XX_fxnTable,
        .object = &sdhostObjects[0],
        .hwAttrs = &sdhostHWattrs[0]
    },
};

const uint_least8_t SD_count = 1;


/*
 *  =============================== SPI ===============================
 */
#include <ti/drivers/SPI.h>
#include <ti/drivers/spi/SPICC32XXDMA.h>

SPICC32XXDMA_Object spiCC3220SDMAObjects[CC3220SF_LAUNCHXL_SPICOUNT];

uint32_t spiCC3220SDMAscratchBuf[CC3220SF_LAUNCHXL_SPICOUNT];

const SPICC32XXDMA_HWAttrsV1 spiCC3220SDMAHWAttrs[CC3220SF_LAUNCHXL_SPICOUNT] = {
    /* index 0 is reserved for LSPI that links to the NWP */
    {
        .baseAddr = LSPI_BASE,
        .intNum = INT_LSPI,
        .intPriority = (~0),
        .spiPRCM = PRCM_LSPI,
        .csControl = SPI_SW_CTRL_CS,
        .csPolarity = SPI_CS_ACTIVEHIGH,
        .pinMode = SPI_4PIN_MODE,
        .turboMode = SPI_TURBO_OFF,
        .scratchBufPtr = &spiCC3220SDMAscratchBuf[CC3220SF_LAUNCHXL_SPI0],
        .defaultTxBufValue = 0,
        .rxChannelIndex = UDMA_CH12_LSPI_RX,
        .txChannelIndex = UDMA_CH13_LSPI_TX,
        .minDmaTransferSize = 100,
        .mosiPin = SPICC32XXDMA_PIN_NO_CONFIG,
        .misoPin = SPICC32XXDMA_PIN_NO_CONFIG,
        .clkPin = SPICC32XXDMA_PIN_NO_CONFIG,
        .csPin = SPICC32XXDMA_PIN_NO_CONFIG
    }
};

const SPI_Config SPI_config[CC3220SF_LAUNCHXL_SPICOUNT] = {
    {
        .fxnTablePtr = &SPICC32XXDMA_fxnTable,
        .object = &spiCC3220SDMAObjects[CC3220SF_LAUNCHXL_SPI0],
        .hwAttrs = &spiCC3220SDMAHWAttrs[CC3220SF_LAUNCHXL_SPI0]
    }
};

const uint_least8_t SPI_count = CC3220SF_LAUNCHXL_SPICOUNT;


/*
 *  ============================= Display =============================
 */

#include <ti/display/Display.h>
#include <ti/display/DisplayUart.h>

#define Display_UARTBUFFERSIZE 1024
static char displayUARTBuffer[Display_UARTBUFFERSIZE];

DisplayUart_Object displayUartObject;

const DisplayUart_HWAttrs displayUartHWAttrs = {
    .uartIdx      = CONFIG_UART_0,
    .baudRate     = 115200,
    .mutexTimeout = (unsigned int)(-1),
    .strBuf       = displayUARTBuffer,
    .strBufLen    = Display_UARTBUFFERSIZE
};

const Display_Config Display_config[] = {
    /* CONFIG_Display_0 */
    /* XDS110 UART */
    {
        .fxnTablePtr = &DisplayUartMin_fxnTable,
        .object      = &displayUartObject,
        .hwAttrs     = &displayUartHWAttrs
    },
};

const uint_least8_t Display_count = 1;


/*
 *  =============================== UART ===============================
 */

#include <ti/drivers/UART.h>
#include <ti/devices/cc32xx/inc/hw_ints.h>
#include <ti/devices/cc32xx/inc/hw_memmap.h>
#include <ti/drivers/uart/UARTCC32XXDMA.h>

#define CONFIG_UART_COUNT 1

#define UART0_BASE UARTA0_BASE
#define UART1_BASE UARTA1_BASE
#define INT_UART0  INT_UARTA0
#define INT_UART1  INT_UARTA1


UARTCC32XXDMA_Object uartCC32XXObjects0;

static const UARTCC32XXDMA_HWAttrsV1 uartCC32XXHWAttrs0 = {
    .baseAddr           = UART0_BASE,
    .intNum             = INT_UART0,
    .intPriority        = (~0),
    .flowControl        = UARTCC32XXDMA_FLOWCTRL_NONE,
    .rxChannelIndex     = UDMA_CH8_UARTA0_RX,
    .txChannelIndex     = UDMA_CH9_UARTA0_TX,
    .rxPin              = UARTCC32XXDMA_PIN_57_UART0_RX,
    .txPin              = UARTCC32XXDMA_PIN_55_UART0_TX,
    .ctsPin             = UARTCC32XXDMA_PIN_UNASSIGNED,
    .rtsPin             = UARTCC32XXDMA_PIN_UNASSIGNED,
    .errorFxn           = NULL
  };

const UART_Config UART_config[CONFIG_UART_COUNT] = {
    {   /* CONFIG_UART_0 */
        .fxnTablePtr = &UARTCC32XXDMA_fxnTable,
        .object      = &uartCC32XXObjects0,
        .hwAttrs     = &uartCC32XXHWAttrs0
    },
};

const uint_least8_t UART_count = CONFIG_UART_COUNT;





/*
 *  ======== Board_debugHeader ========
 *  This structure prevents the CC32XXSF bootloader from overwriting the
 *  internal FLASH; this allows us to flash a program that will not be
 *  overwritten by the bootloader with the encrypted program saved in
 *  "secure/serial flash".
 *
 *  This structure must be placed at the beginning of internal FLASH (so
 *  the bootloader is able to recognize that it should not overwrite
 *  internal FLASH).
 */
#if defined (__SF_DEBUG__) || defined(__SF_NODEBUG__)
#if defined(__TI_COMPILER_VERSION__)
#pragma DATA_SECTION(Board_debugHeader, ".dbghdr")
#pragma RETAIN(Board_debugHeader)
#elif defined(__IAR_SYSTEMS_ICC__)
#pragma location=".dbghdr"
#elif defined(__GNUC__)
__attribute__ ((section (".dbghdr")))
#endif
#if defined(__SF_DEBUG__)
const uint32_t Board_debugHeader[] = {
    0x5AA5A55A,
    0x000FF800,
    0xEFA3247D
};
#elif defined (__SF_NODEBUG__)
const uint32_t Board_debugHeader[] = {
    0xFFFFFFFF,
    0xFFFFFFFF,
    0xFFFFFFFF
};
#endif
#endif
