halitosisman/SeniorDesign/GauntletMCU/CCS_Project/Finity_MCU_Core/drivers/LCD/ILI9341.h

/*
 * lcd.h
 *
 *  Created on: Feb 21, 2020
 *      Author: pbloemer
 */

#ifndef DRIVERS_LCD_ILI9341_H_
#define DRIVERS_LCD_ILI9341_H_


#include <stdint.h>
#include <unistd.h>


#ifdef __cplusplus
extern "C" {
#endif


/*
 *  These defines ripped from https://github.com/adafruit/TFTLCD-Library/blob/master/registers.h
 */

#define ILI9341_BITS_PER_RED 5
#define ILI9341_BITS_PER_GREEN 6
#define ILI9341_BITS_PER_BLUE 5


#define ILI9341_SOFTRESET 0x01
#define ILI9341_SLEEPIN 0x10
#define ILI9341_SLEEPOUT 0x11
#define ILI9341_NORMALDISP 0x13
#define ILI9341_INVERTOFF 0x20
#define ILI9341_INVERTON 0x21
#define ILI9341_GAMMASET 0x26
#define ILI9341_DISPLAYOFF 0x28
#define ILI9341_DISPLAYON 0x29
#define ILI9341_COLADDRSET 0x2A
#define ILI9341_PAGEADDRSET 0x2B
#define ILI9341_MEMORYWRITE 0x2C
#define ILI9341_PIXELFORMAT 0x3A
#define ILI9341_FRAMECONTROL 0xB1
#define ILI9341_DISPLAYFUNC 0xB6
#define ILI9341_ENTRYMODE 0xB7
#define ILI9341_POWERCONTROL1 0xC0
#define ILI9341_POWERCONTROL2 0xC1
#define ILI9341_VCOMCONTROL1 0xC5
#define ILI9341_VCOMCONTROL2 0xC7
#define ILI9341_MEMCONTROL 0x36
#define ILI9341_MADCTL 0x36

#define ILI9341_MADCTL_MY 0x80
#define ILI9341_MADCTL_MX 0x40
#define ILI9341_MADCTL_MV 0x20
#define ILI9341_MADCTL_ML 0x10
#define ILI9341_MADCTL_RGB 0x00
#define ILI9341_MADCTL_BGR 0x08
#define ILI9341_MADCTL_MH 0x04

#define DCX_CMD 0x0
#define DCX_DATA 0xFF

#define NO_CMD 0
#define ONE_BYTE_CMD 1
#define TWO_BYTE_CMD 2
#define FOUR_BYTE_CMD 4


/*!
    \brief          write8

    Callback for writing a single byte to the ILI9341

    \param          uint8_t    -   The byte to be written

    \return         void

    \note           The user needs to define a custom implementation of this for a particular MCU. The FG project has a
                    implementation of this under lcd_task.c.

*/
void write8(uint8_t val);

/*!
    \brief          ILI_write_bulk

    Writes cnt members of buf to the ILI9341. This does not select the address to write to.

    \param          uint8_t *  -   buffer to write.

    \param          uint8_t    -   Number of bytes to write.

    \return         void

    \note           The user needs to define a custom implementation of this for a particular MCU. The FG project has a
                    implementation of this under lcd_task.c.

*/
void ILI_write_bulk(uint8_t * buf, uint16_t cnt);

/*!
    \brief          ILI_write_color

    Writes num instances of the color defined in color to the ILI9341. A different function must select the ILI9341
    address to write to.

    \param          uint8_t *  -   buffer to write.

    \param          uint8_t    -   The length of the color defined in var color.

    \param          num    -   The number of times to write a color.

    \return         void

    \note           The user needs to define a custom implementation of this for a particular MCU. The FG project has a
                    implementation of this under lcd_task.c.

*/
void ILI_write_color(uint8_t * color, uint8_t color_len, int num);


/*!
    \brief          set_dcx

    Callback for setting the dcx line high or low.

    \param          uint8_t    -   0xFF for command and 0x0 for data.

    \return         void

    \note           The user needs to define a custom implementation of this for a particular MCU. The FG project has a
                    implementation of this under lcd_task.c.

*/
inline void set_dcx(uint8_t val);


#ifdef __cplusplus
}
#endif



#endif /* DRIVERS_LCD_ILI9341_H_ */
