halitosisman/SeniorDesign/GauntletMCU/CCS_Project/Finity_MCU_Core/drivers/LCD/ILI9341.c

/*
 * lcd.c
 *
 *  Created on: Feb 21, 2020
 *      Author: pbloemer
 *
 *
 *      Initialization code largely copied from
 *       https://github.com/adafruit/TFTLCD-Library/blob/master/Adafruit_TFTLCD.cpp for source on initialization
 *
 */


#include "ILI9341.h"
