halitosisman/SeniorDesign/(commit log)

2020-03-09 Added Pcb design files
    [Display.brd, Display.kicad_pcb, Display.sch, HallE.brd, HallE.kicad_pcb, HallE.sch, Main_v3.brd, Main_v3.kicad_pcb]
2020-04-03 Updated PCB files and ported some of the graphics functions. The graphics changes are not tested yet.
    [Display.brd, Display.kicad_pcb, Display.sch, Main_v3.brd, Main_v3.kicad_pcb, Main_v3.sch]
2020-04-19 2/3 GUI prototypes.
2020-04-20 Began I2C thread work
2020-04-20 GUI stuff working and first draft of ADC drivers.
2020-04-21 First contact between I2C and ADC.
2020-04-21 Added a picture of the circuitboard schematic
2020-04-22 ADC over I2C functionality implemented.
2020-04-22 Ongoing work on i2c and gui task integration.
2020-04-26 Fixed I2C_open fault, made the taskhandles get properly referenced from within threads. God I wish TI would fix their driver bugs.
    [AsyncI2C.c, CC3220SF.c, CC3220SF.h, gui_task.cpp, gui_task.h, i2c_task.cpp, i2c_task.h]
2020-04-27 Got I2C alerts working.
2020-04-27 I2C integration finished. Networking integration started.
2020-04-28 Pretty sure the cause of bugs is TI's signature undocumented POSIX behaviors.
    [main_freertos.cpp, net_task.c, net_task.h, thread_config.h]
2020-04-30 Most bugs ironed out. GUI is functional.
    [gui_task.cpp, net_task.c]
2020-05-04 Added some stuff to the 3d mockup file and a bunch of comments to the main project.
    [MockupV1.blend]
