halitosisman/SeniorDesign/(notices)

Notices in the files:
parts and their libraries:
SparkFun-PowerSymbols: Licensing: Creative Commons ShareAlike 4.0 International - https://creativecommons.org/licenses/by-sa/4.0
COPYRIGHT: Copyright (C) 2018 Accelerated Designs. All rights reserved
